lethanhsonvsp/robot_BV/VIDEO ẢNH/ảnh  (3).png

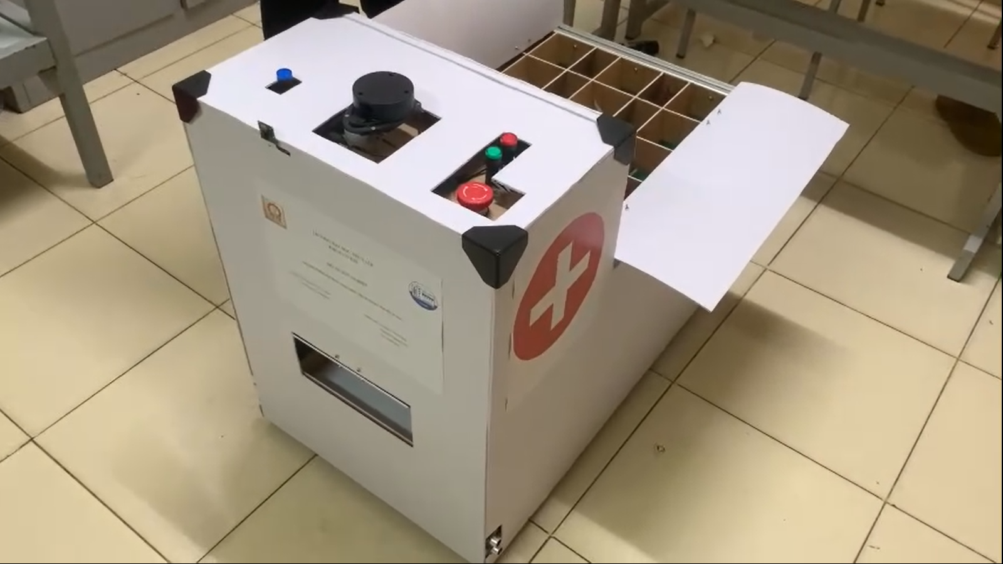
VIDEO ẢNH/ảnh (3).png
