lethanhsonvsp/robot_BV/VIDEO ẢNH/ảnh  (1).png

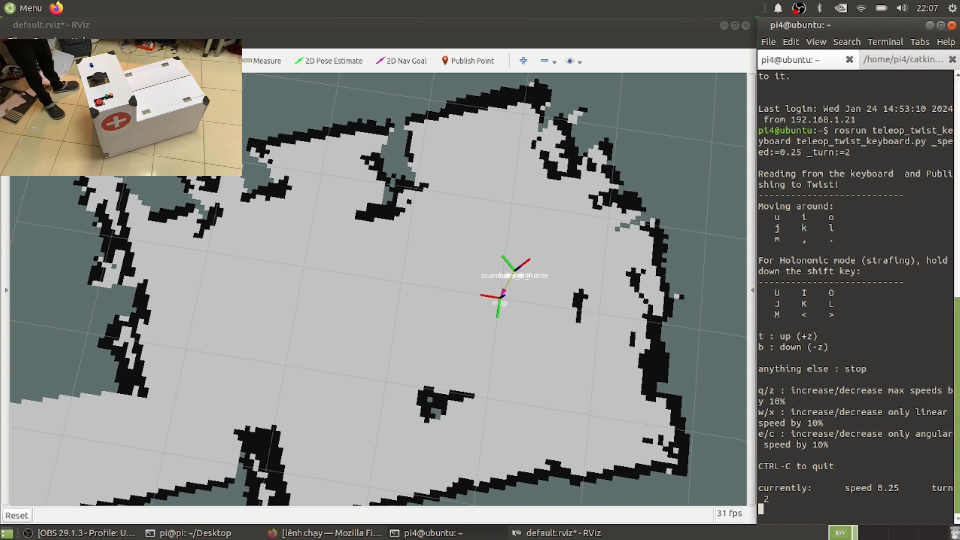
VIDEO ẢNH/ảnh (1).png
