lethanhsonvsp/robot_BV/README.md

link_full

https://drive.google.com/drive/folders/1wz2qDpS3KL3dy9zkgHuYTbrtM0P3PQ5b?usp=sharing 

Youtube

https://youtube.com/playlist?list=PLt1V7U89L8Tuf9y2Dy6GURRMbIHLNL2lR&si=jejB6wj2ichqqmJI
