lethanhsonvsp/robot_BV/VIDEO ẢNH/ảnh  (2).png

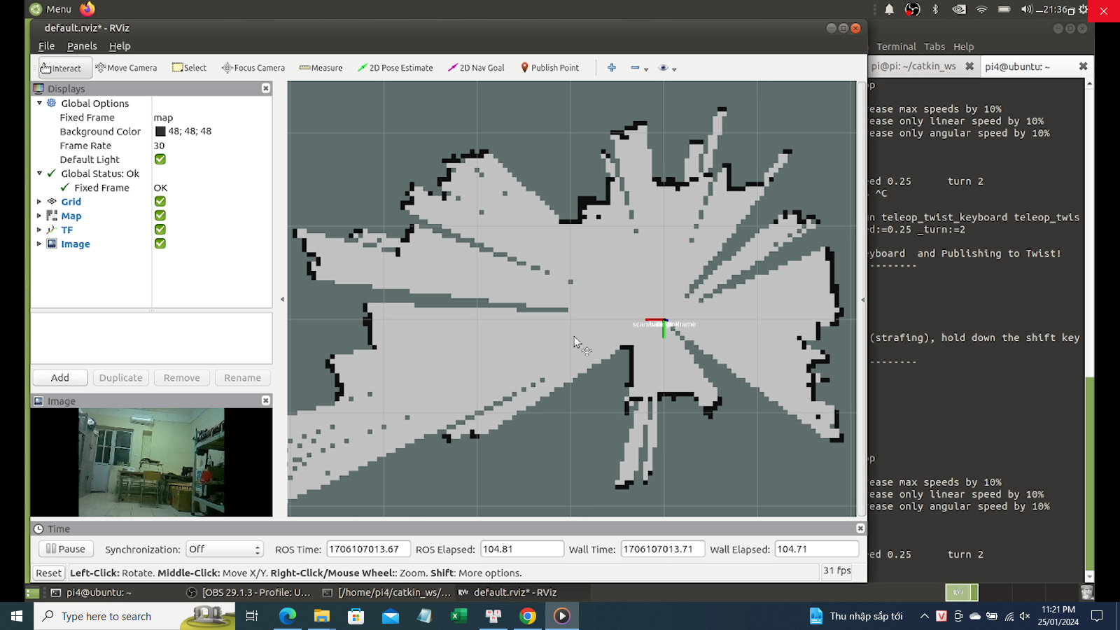
VIDEO ẢNH/ảnh (2).png
