lethanhsonvsp/robot_BV/BAN_VE/A3 Lưu đồ thuật toán hệ thống.pdf

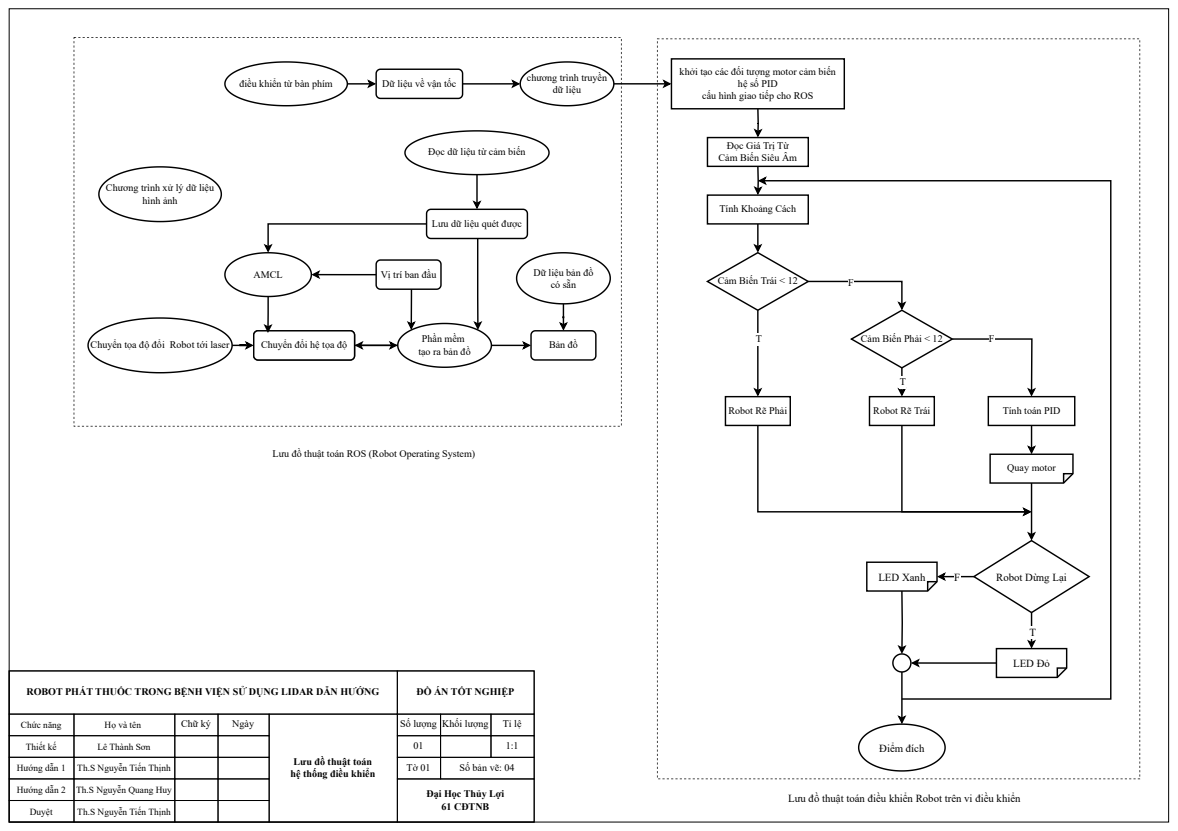
[picture p45: page 1]
ROBOT PHÁT THUỐC TRONG BỆNH VIỆN SỬ DỤNG LIDAR DẪN HƯỚNG; ĐỒ ÁN TỐT NGHIỆP; Chức năng; Thiết kế; Hướng dẫn 1; Duyệt; Chữ ký; Ngày; Số lượng Khối lượng; Hướng dẫn 2; Số bản vẽ: 04; Cảm Biến Phải < 12; Điểm đích; Robot Rẽ Phải; Robot Rẽ Trái; Tính toán PID; Quay motor; LED Xanh; LED Đỏ; chuyển_đổi_hệ_tọa_độ; Chuyển tọa độ đổi Robot tới laser; Phần mềm; AMCL; Dữ liệu bản đồ; có sẵn; Chuyển đổi hệ tọa độ; Bản đồ; hình ảnh

khởi tạo các đối tượng motor cảm biến

điều khiển từ bàn phím

Dữ liệu về vận tốc

chương trình truyền
dữ liệu

hệ số PID

cấu hình giao tiếp cho ROS

Đọc Giá Trị Từ
Cảm Biến Siêu Âm

Đọc dữ liệu từ cảm biến

Chương trình xử lý dữ liệu

Tính Khoảng Cách

Lưu dữ liệu quét được

Vị trí ban đầu

Cảm Biến Trái < 12

tạo ra bản đồ

Lưu đồ thuật toán ROS (Robot Operating System)

Robot Dừng Lại

Họ và tên

Lê Thành Sơn

Lưu đồ thuật toán
hệ thống điều khiển

Th.S Nguyễn Tiến Thịnh

Th.S Nguyễn Quang Huy

Đại Học Thủy Lợi
61 CĐTNB

Lưu đồ thuật toán điều khiển Robot trên vi điều khiển
