lethanhsonvsp/robot_BV/BAN_VE/A3 Sơ đồ khối hệ thống điều khiển.PDF

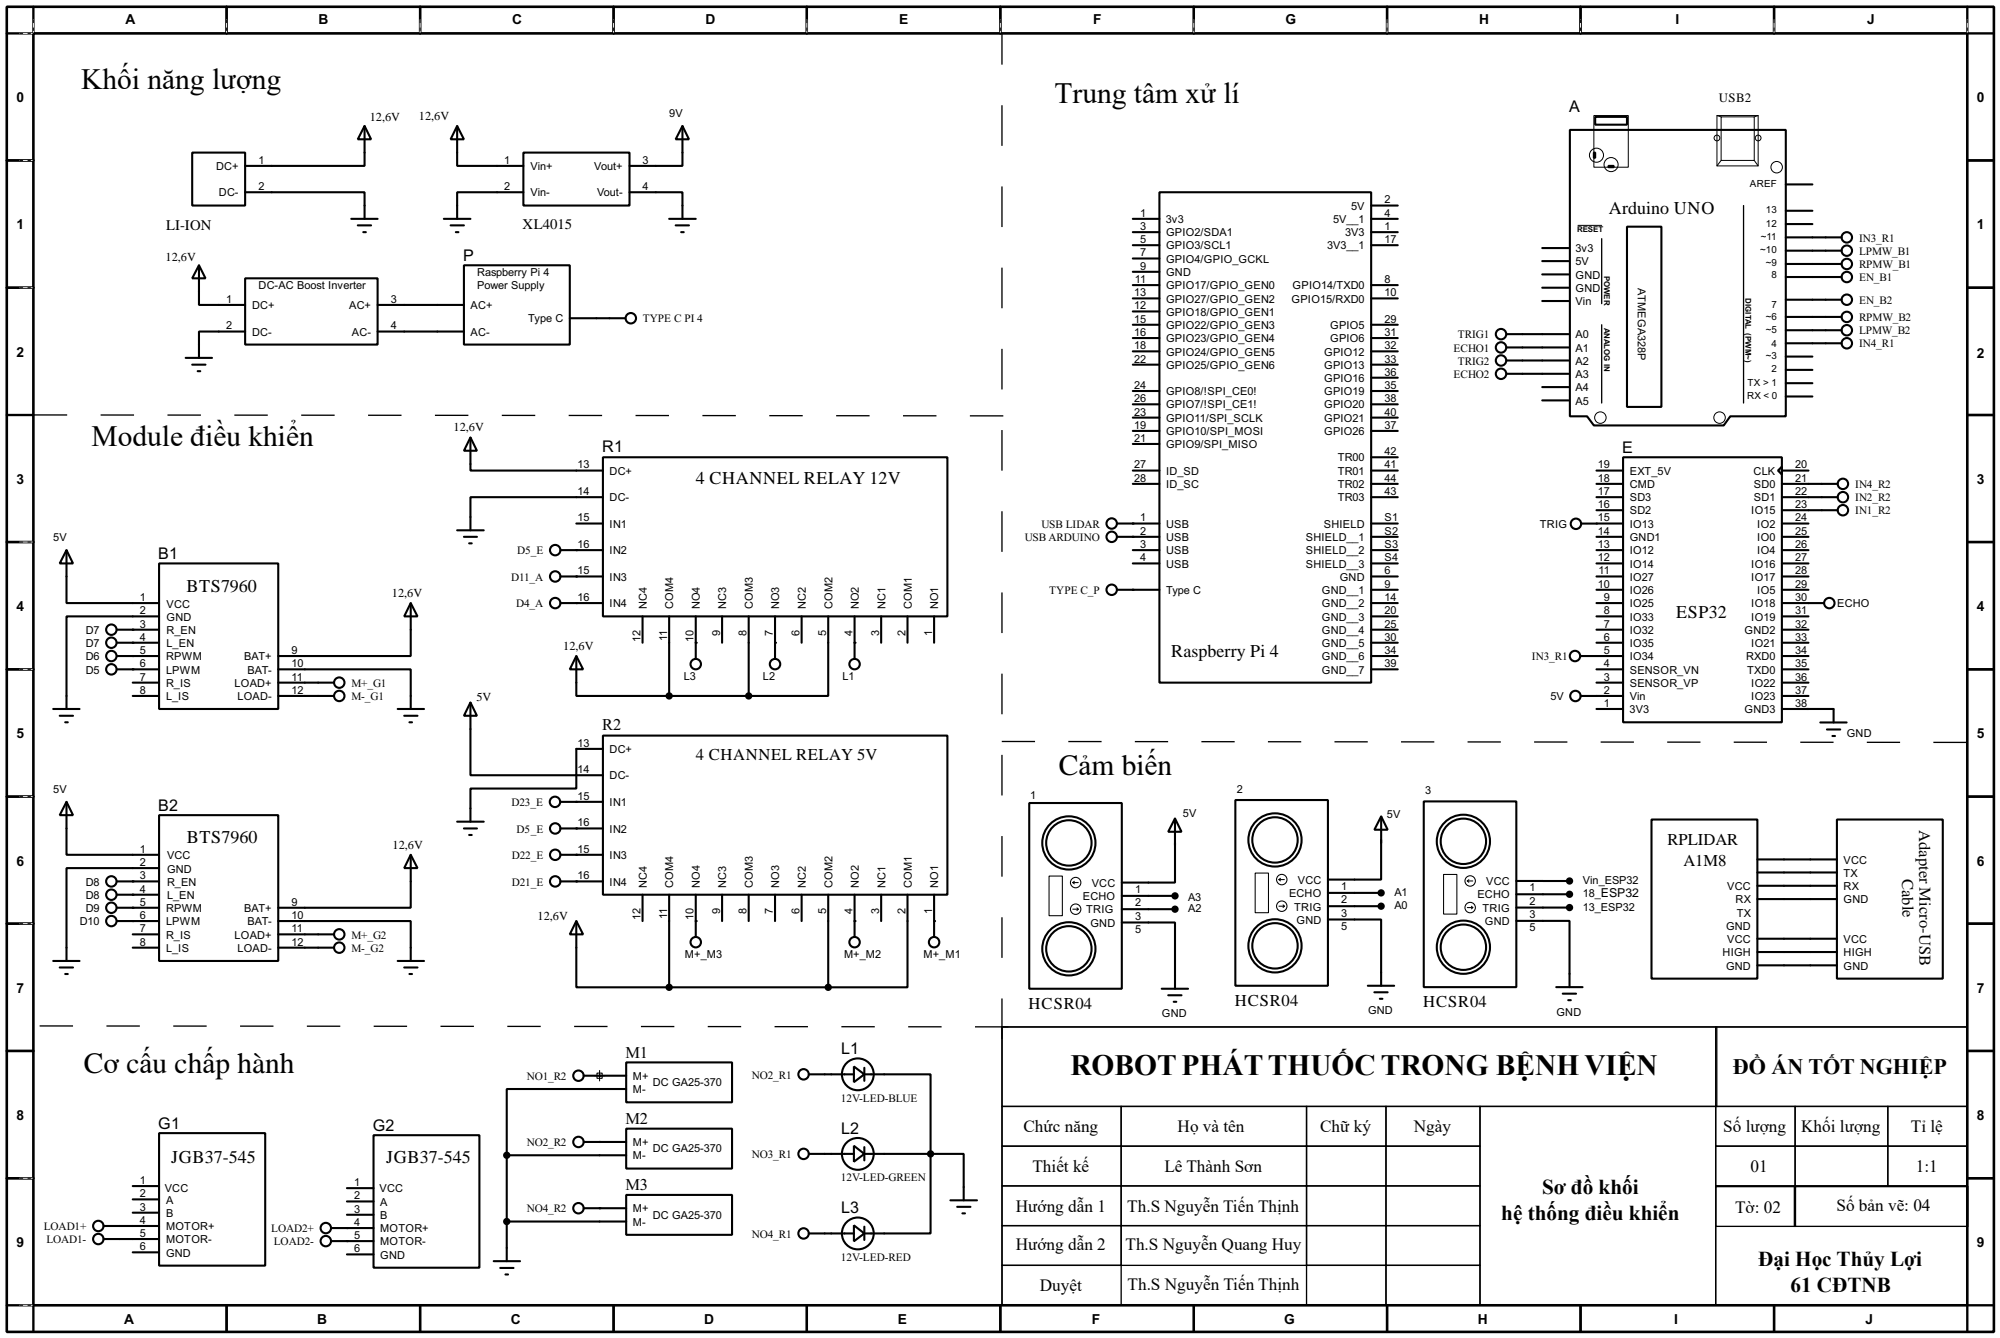
[picture p46: page 1]

ANALOG IN 3v3 GND GND

DC-AC Boost Inverter AC+

Cơ cấu chấp hành

Chức năng | Họ và tên | Chữ ký | Ngày | Số lượng | Khối lượng | Tỉ lệ

Thiết kế | Lê Thành Sơn | | | 01 | | 1:1

Sơ đồ khối
hệ thống điều khiển

Hướng dẫn 1 | Th.S Nguyễn Tiến Thịnh | | | Tờ: 02 | Số bản vẽ: 04

Hướng dẫn 2 | Th.S Nguyễn Quang Huy

Đại Học Thủy Lợi
61 CĐTNB

Th.S Nguyễn Tiến Thịnh
