lethanhsonvsp/robot_BV/BAN_VE/A3 Sơ đồ nguyên lý.pdf

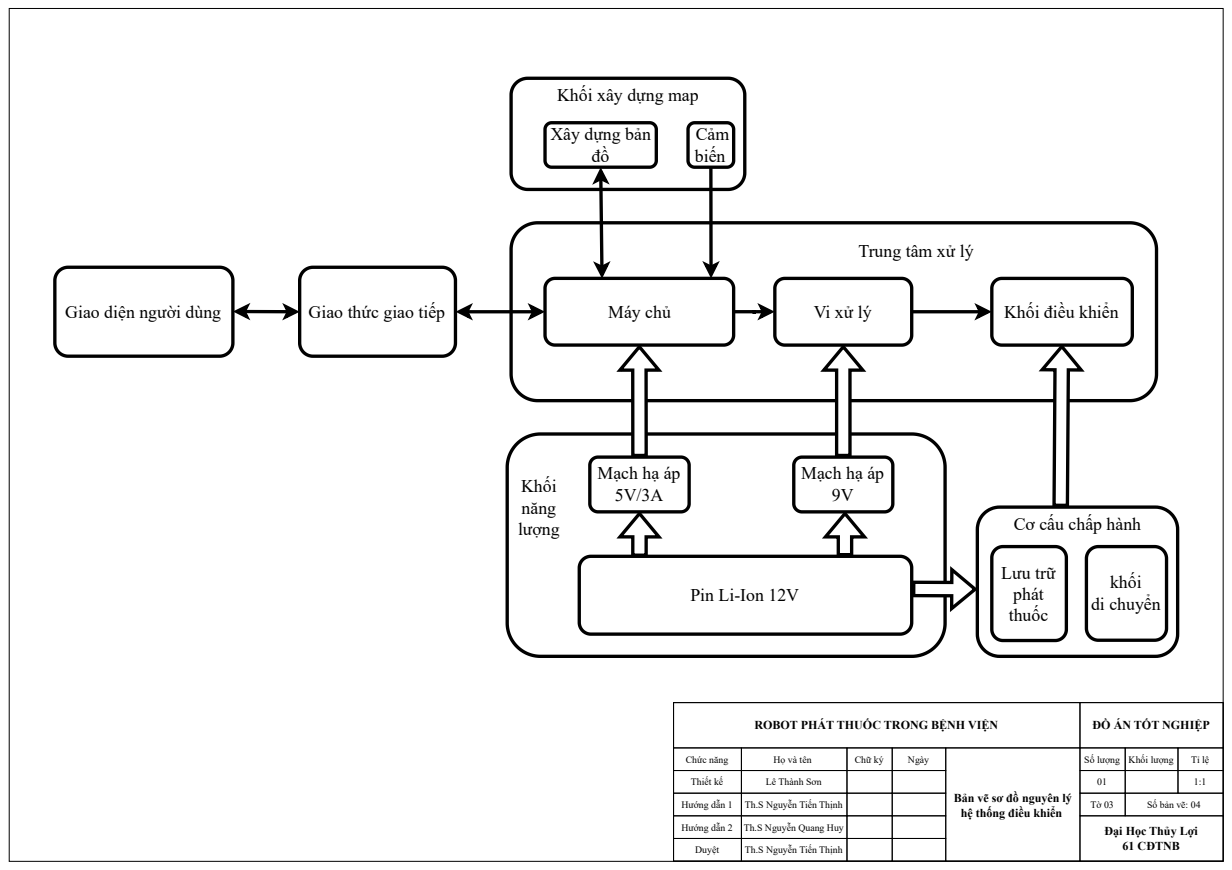
[picture p47: page 1]
Cảm biến; Giao diện người dùng; Máy chủ; Lưu trữ phát thuốc; khối; Khối năng lượng; Giao thức giao tiếp; Khối điều khiển

Khối xây dựng map

Xây dựng bản

Trung tâm xử lý

Mạch hạ áp

Cơ cấu chấp hành

di chuyển Pin Li-Ion 12V

ROBOT PHÁT THUỐC TRONG BỆNH VIỆN | ĐỒ ÁN TỐT NGHIỆP

Chức năng | Họ và tên | Chữ ký | Ngày | hệ thống điều khiển | Số lượng | Khối lượng | Tỉ lệ

Thiết kế | Lê Thành Sơn | | | | 01 | | 1:1
Hướng dẫn 1 | Th.S Nguyễn Tiến Thịnh | | | | Tờ 03 | Số bản vẽ: 04 Bản vẽ sơ đồ nguyên lý

Hướng dẫn 2 | Th.S Nguyễn Quang Huy | | | | Đại Học Thủy Lợi 61 CĐTNB

Duyệt | Th.S Nguyễn Tiến Thịnh
