lethanhsonvsp/robot_BV/BAN_VE/A3 Bản vẽ tổng thể robot.PDF

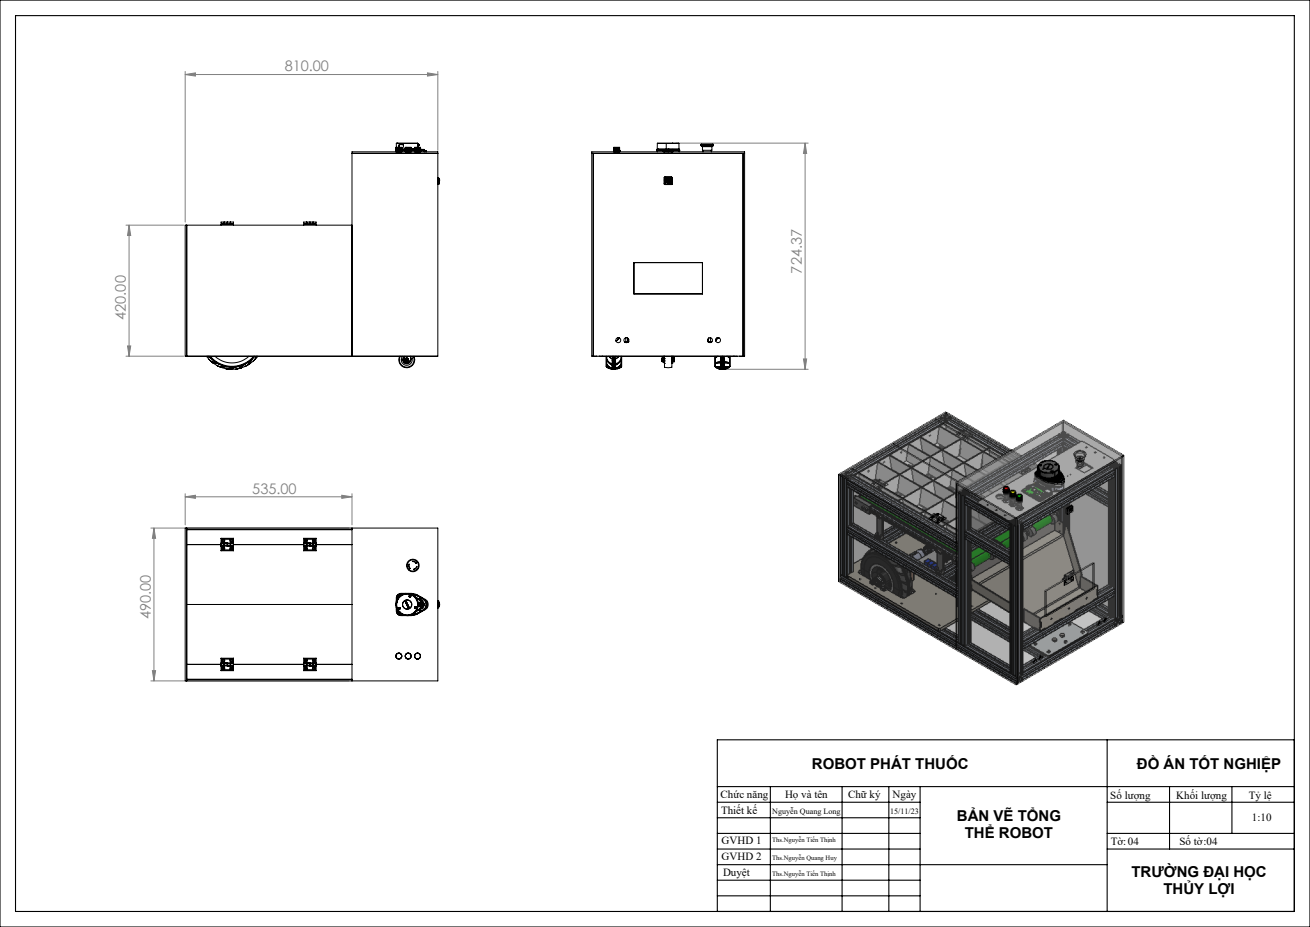
[picture p48: page 1]

ROBOT PHÁT THUỐC | ĐỒ ÁN TỐT NGHIỆP

Chức năng | Họ và tên | Chữ ký | Ngày | BẢN VẼ TỔNG THỂ ROBOT | Số lượng | Khối lượng | Tỷ lệ
Thiết kế | Nguyễn Quang Long | | 15/11/23 | | | | 1:10

GVHD 1 | Ths.Nguyễn Tiến Thịnh | Tờ: 04 | Số tờ :04
GVHD 2 | Ths.Nguyễn Quang Huy | TRƯỜNG ĐẠI HỌC THỦY LỢI
Duyệt | Ths.Nguyễn Tiến Thịnh
